AevumDecessus/Ergo-Nano/docs/images/backplate-bottom.png

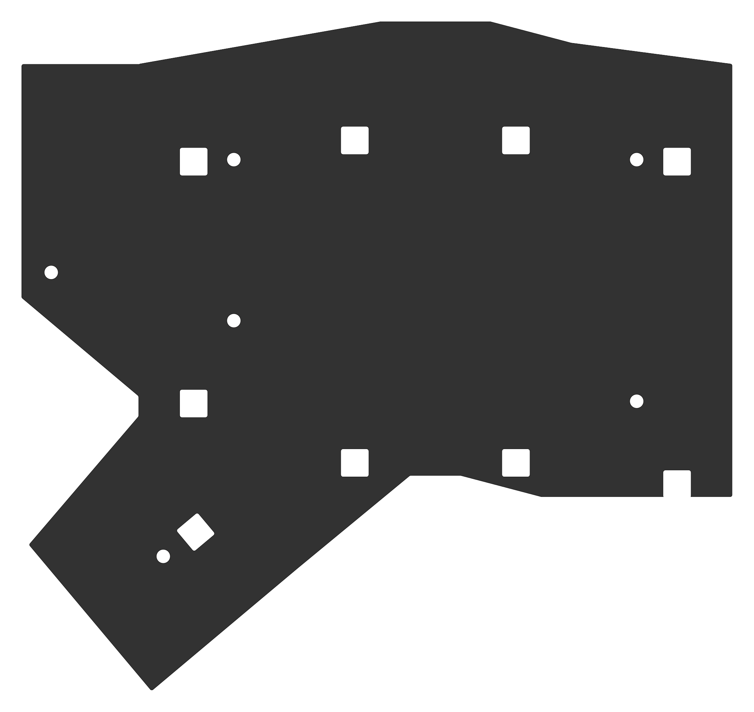
docs/images/backplate-bottom.png
