AevumDecessus/Ergo-Nano/docs/images/backplate-top.png

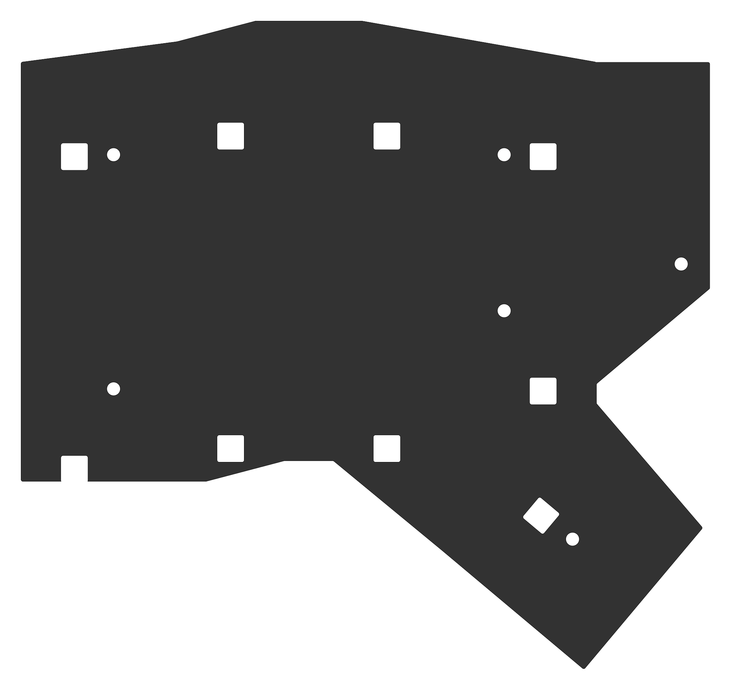
docs/images/backplate-top.png
