AevumDecessus/Ergo-Nano/docs/images/switchplate-bottom.png

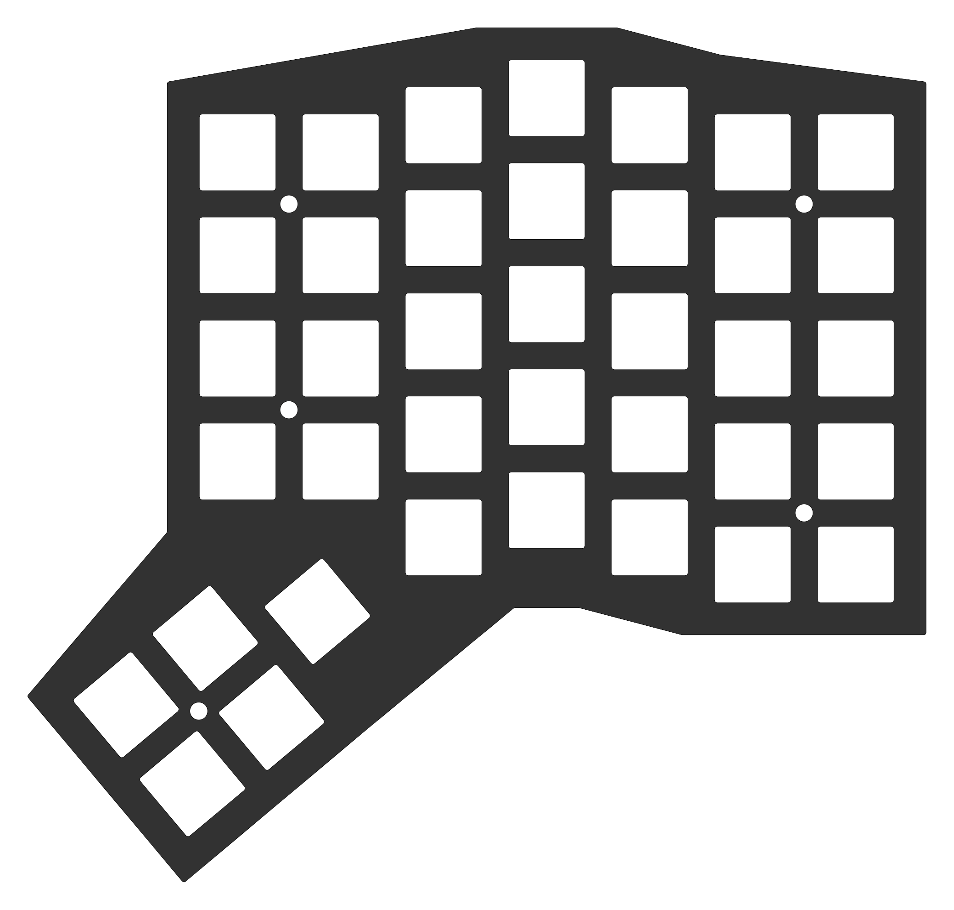
docs/images/switchplate-bottom.png
