AevumDecessus/Ergo-Nano/docs/images/switchplate-top.png

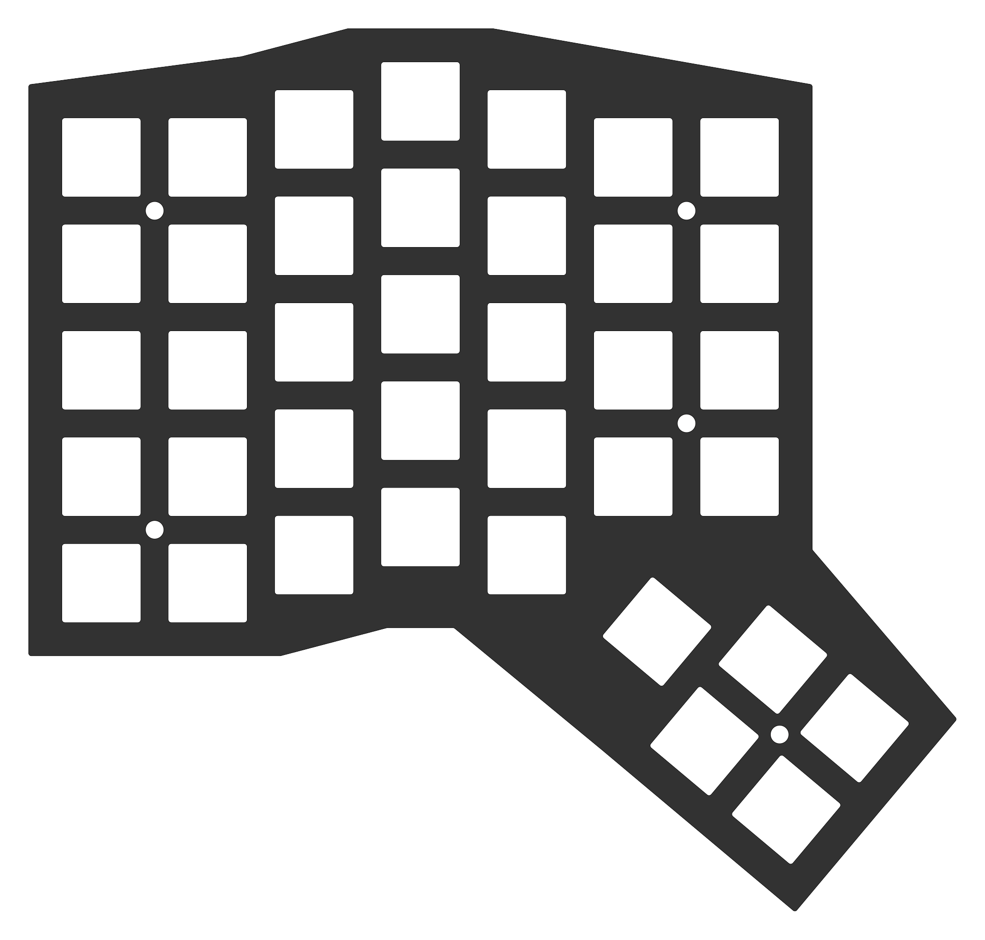
docs/images/switchplate-top.png
