AevumDecessus/Ergo-Nano/cases/bottom_plate.stl

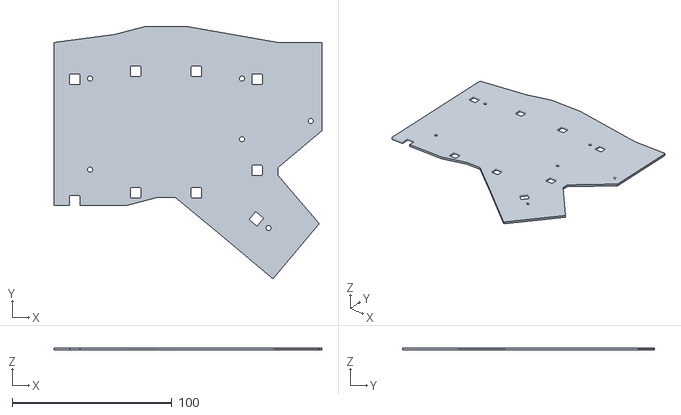
[picture p7: CAD file, 2026-11-09]
cases/bottom_plate.stl
167.6 x 157.6 x 1.50
