AevumDecessus/Ergo-Nano/outlines/preview.dxf

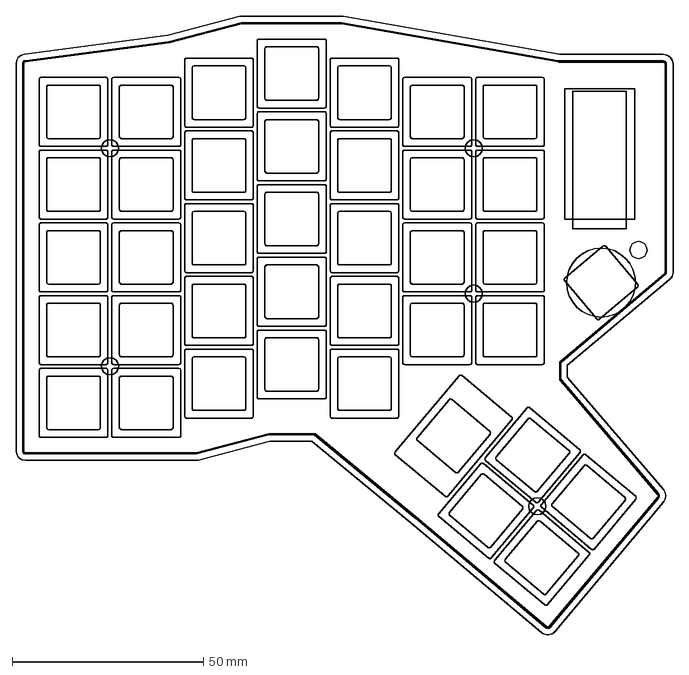
[picture p8: CAD file, 2026-11-09]
outlines/preview.dxf
171.6 x 161.7 mm
