AevumDecessus/Ergo-Nano/cases/switch_test_plate.stl

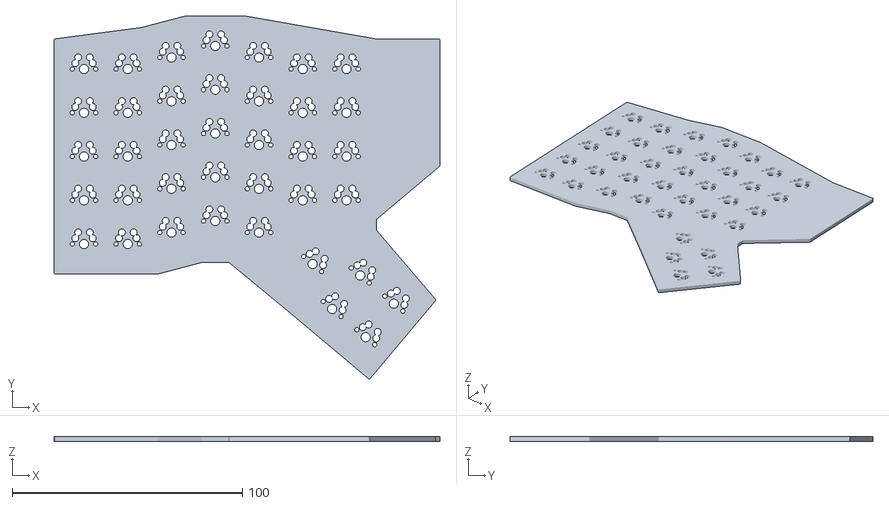
[picture p9: CAD file, 2026-11-09]
cases/switch_test_plate.stl
167.6 x 157.6 x 2.00
