AevumDecessus/Ergo-Nano/outlines/backplate.dxf

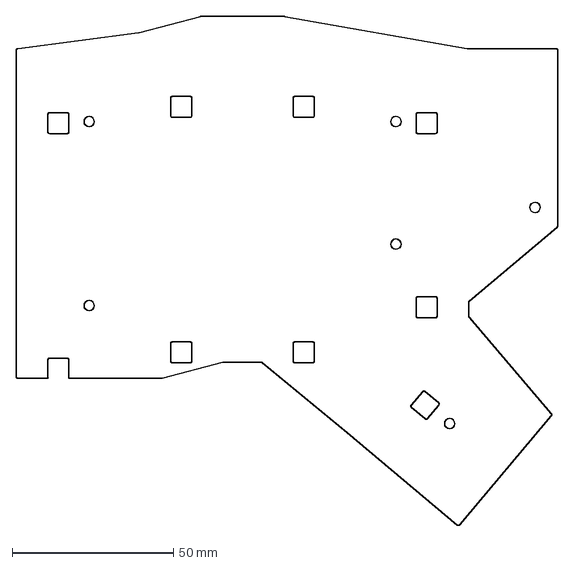
[picture p10: CAD file, 2026-11-09]
outlines/backplate.dxf
167.6 x 157.6 mm
