AevumDecessus/Ergo-Nano/cases/bottom_case_pcb.stl

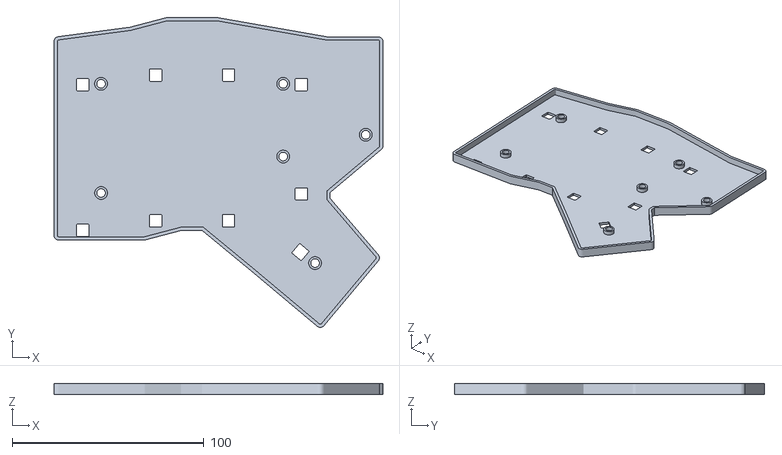
[picture p11: CAD file, 2026-11-09]
cases/bottom_case_pcb.stl
171.6 x 161.6 x 5.60
