AevumDecessus/Ergo-Nano/outlines/switchplate.dxf

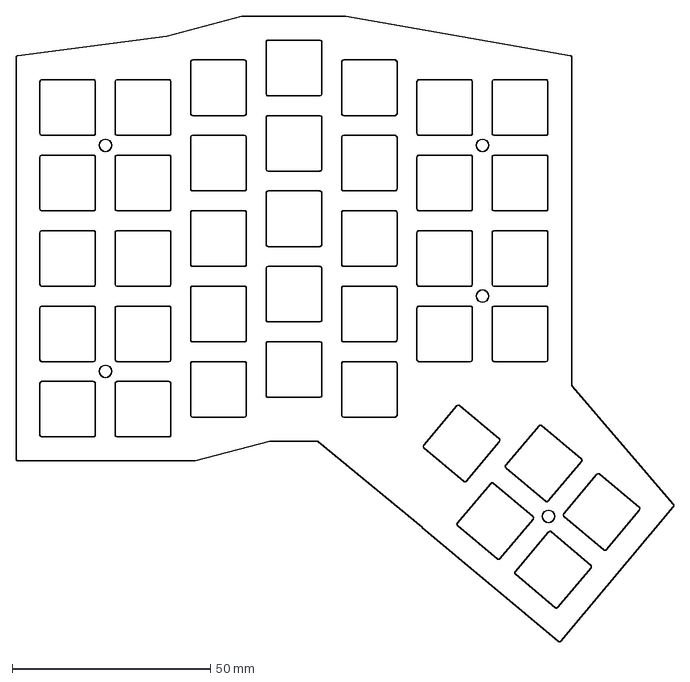
[picture p12: CAD file, 2026-11-09]
outlines/switchplate.dxf
165.8 x 157.6 mm
