AevumDecessus/Ergo-Nano/cases/bottom_case_switch.stl

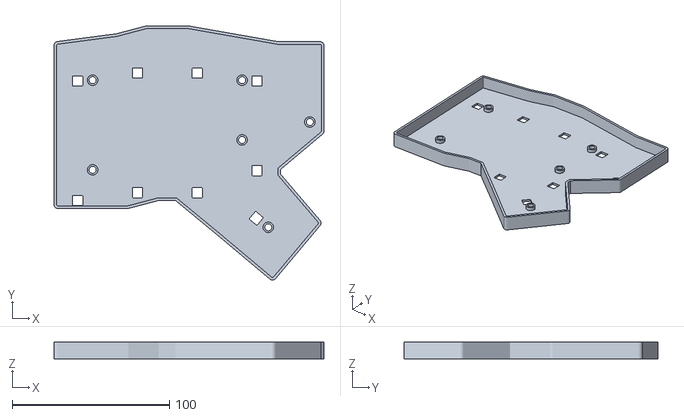
[picture p13: CAD file, 2026-11-09]
cases/bottom_case_switch.stl
171.6 x 161.6 x 10.6
