AevumDecessus/Ergo-Nano/cases/bottom_case_deep.stl

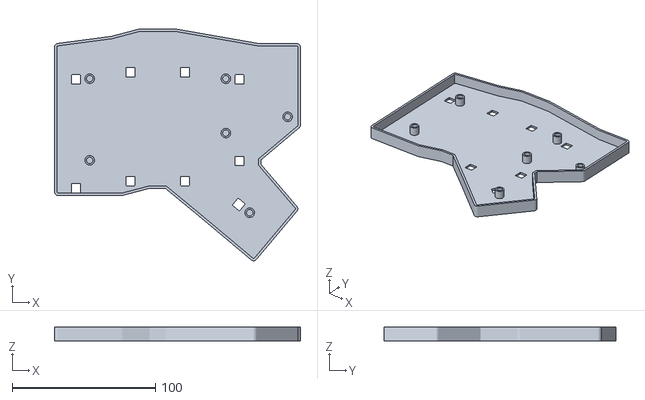
[picture p14: CAD file, 2026-11-09]
cases/bottom_case_deep.stl
171.6 x 161.6 x 9.60
