AevumDecessus/Ergo-Nano/pcbs/ergonano.kicad_pcb

## KiCad design pcbs/ergonano.kicad_pcb (2026-11-13)

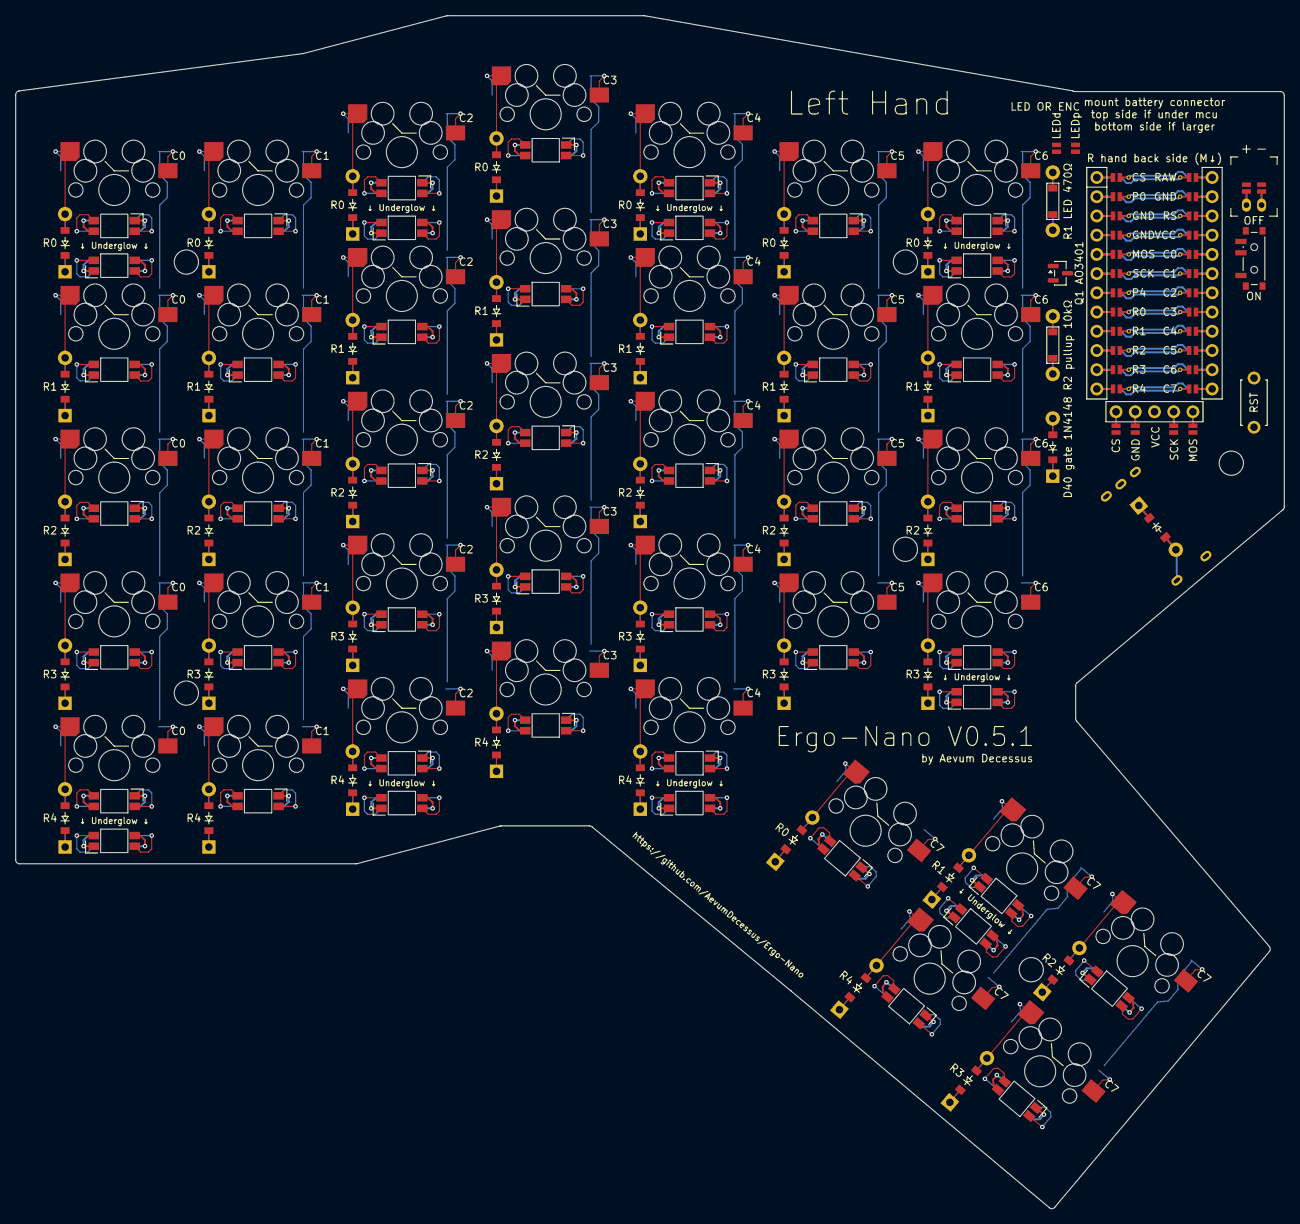
[picture p15: board ergonano.kicad_pcb from above]

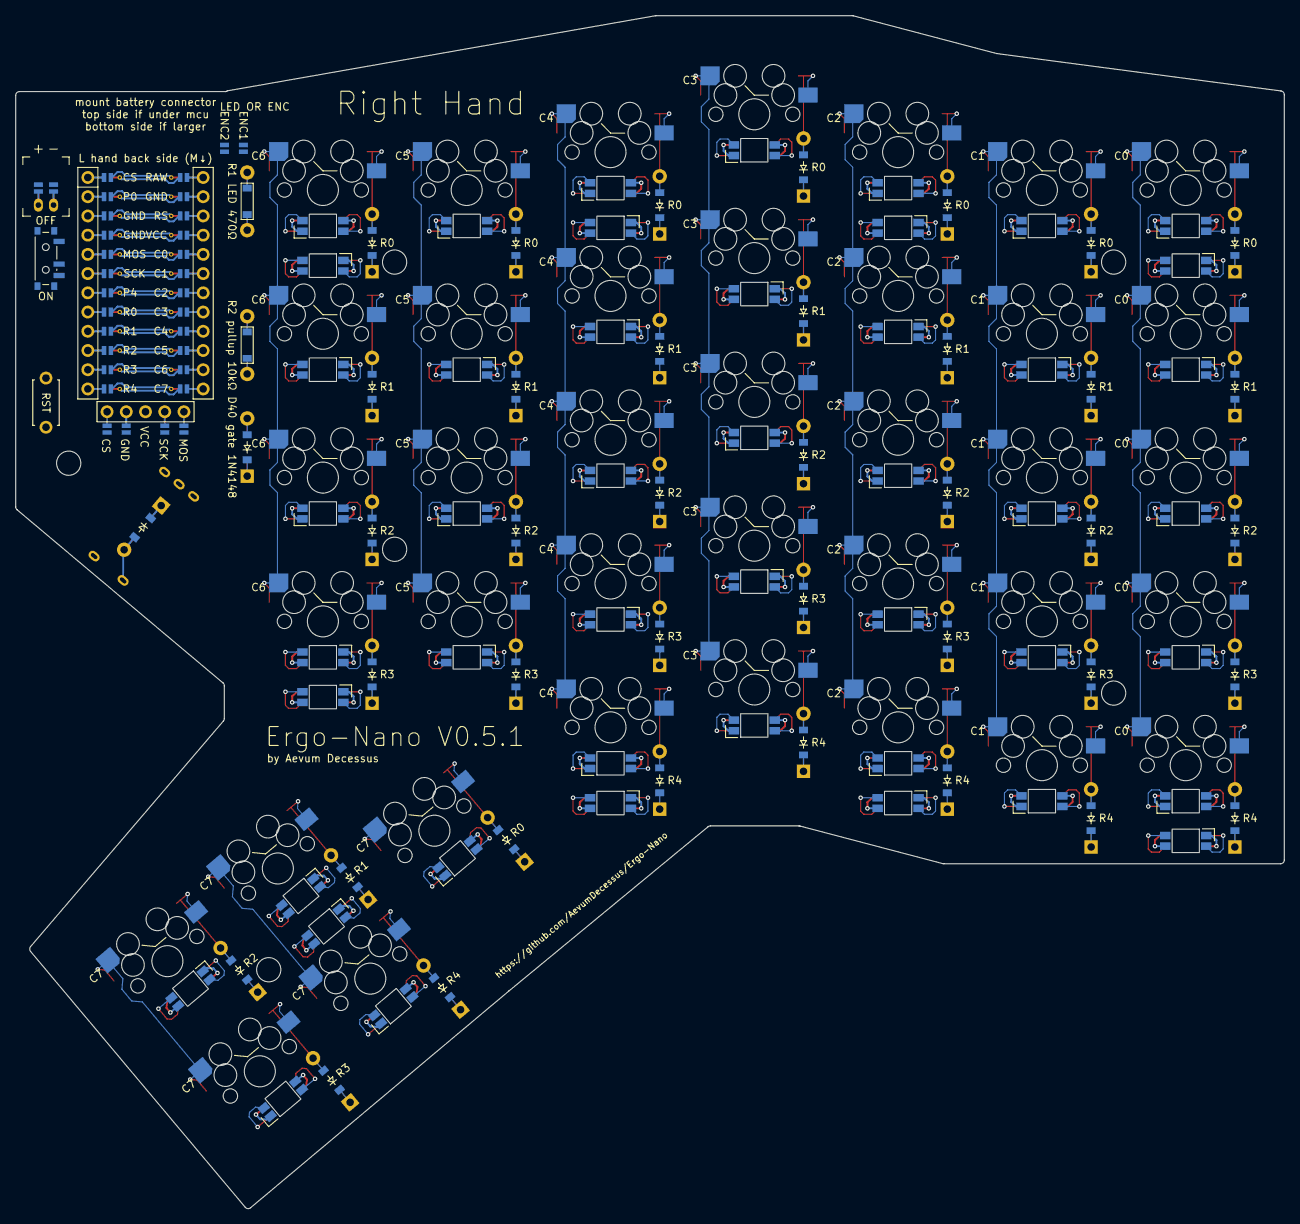
[picture p16: board ergonano.kicad_pcb from below]

Board: 2 copper layers, 167.6 x 157.6 mm, 144 parts (87 on the bottom side), 121 nets.

Parts:
D1, D2, D3, D4, D5, D6, D7, D8, D9, D10, D11, D12, D13, D14, D15, D16, D17, D18, D19, D20, D21, D22, D23, D24, D25, D26, D27, D28, D29, D30, D31, D32, D33, D34, D35, D36, D37, D38, D39, D40: diode_tht_sod123
DISP1: display_nice_view
J1, J2, J3, J4: jumper
JST1: battery_connector_jst_ph_2
LED1, LED2, LED3, LED4, LED5, LED6, LED7, LED8, LED9, LED10, LED11, LED12, LED13, LED14, LED15, LED16, LED17, LED18, LED19, LED20, LED21, LED22, LED23, LED24, LED25, LED26, LED27, LED28, LED29, LED30, LED31, LED32, LED33, LED34, LED35, LED36, LED37, LED38, LED39, LED40, LED41, LED42, LED43, LED44, LED45, LED46, LED47: led_SK6812mini-e (per-key, reversible)
MCU1: mcu_nice_nano
MH1, MH2, MH3, MH4, MH5, MH6: mounting_hole_npth
PWR1: power_switch_smd_side
Q1: SOT-23
R1, R2: resistor_tht_1206
RE1: rotary_encoder_ec11_ec12
RST1: reset_switch_tht_top
S1, S2, S3, S4, S5, S6, S7, S8, S9, S10, S11, S12, S13, S14, S15, S16, S17, S18, S19, S20, S21, S22, S23, S24, S25, S26, S27, S28, S29, S30, S31, S32, S33, S34, S35, S36, S37, S38: switch_mx

Connections:
BAT_P: JST1.1, PWR1.1, PWR1.3
C0: MCU1.105, S1.1, S1.2, S2.1, S2.2, S3.1, S3.2, S4.1, S4.2, S5.1, S5.2
C1: MCU1.106, S6.1, S6.2, S7.1, S7.2, S8.1, S8.2, S9.1, S9.2, S10.1, S10.2
C2: MCU1.107, S11.1, S11.2, S12.1, S12.2, S13.1, S13.2, S14.1, S14.2, S15.1, S15.2
C3: MCU1.108, S16.1, S16.2, S17.1, S17.2, S18.1, S18.2, S19.1, S19.2, S20.1, S20.2
C4: MCU1.109, S21.1, S21.2, S22.1, S22.2, S23.1, S23.2, S24.1, S24.2, S25.1, S25.2
C5: MCU1.110, S26.1, S26.2, S27.1, S27.2, S28.1, S28.2, S29.1, S29.2
C6: MCU1.111, RE1.S1, S30.1, S30.2, S31.1, S31.2, S32.1, S32.2, S33.1, S33.2
C7: MCU1.112, S34.1, S34.2, S35.1, S35.2, S36.1, S36.2, S37.1, S37.2, S38.1, S38.2
CS: DISP1.10, DISP1.20, MCU1.124
DISP1_1: DISP1.1, DISP1.14, DISP1.27
DISP1_2: DISP1.2, DISP1.15, DISP1.26
DISP1_4: DISP1.4, DISP1.16, DISP1.25
DISP1_5: DISP1.5, DISP1.17, DISP1.24
E1: J3.2, RE1.A
E2: J4.2, RE1.C
GND: DISP1.11, DISP1.21, JST1.2, LED1.3, LED2.3, LED3.3, LED4.3, LED5.3, LED6.3, LED7.3, LED8.3, LED9.3, LED10.3, LED11.3, LED12.3, LED13.3, LED14.3, LED15.3, LED16.3, LED17.3, LED18.3, LED19.3, LED20.3, LED21.3, LED22.3, LED23.3, LED24.3, LED25.3, LED26.3, LED27.3, LED28.3, LED29.3, LED30.3, LED31.3, LED32.3, LED33.3, LED34.3, LED35.3, LED36.3, LED37.3, LED38.3, LED39.3, LED40.3, LED41.3, LED42.3, LED43.3, LED44.3, LED45.3, LED46.3, LED47.3, MCU1.102, MCU1.121, MCU1.122, RE1.B, RST1.2
JST1_1: JST1.11, JST1.21, JST1.31
JST1_2: JST1.12, JST1.22, JST1.32
J_LED: J1.2, R1.2
J_MFET_GATE: D40.1, J2.2
LED_0: LED19.4, R1.1
LED_1: LED17.4, LED19.2
LED_2: LED15.4, LED17.2
LED_3: LED12.4, LED15.2
LED_4: LED9.4, LED12.2
LED_5: LED6.4, LED9.2
LED_6: LED3.4, LED6.2
LED_7: LED3.2, LED24.4
LED_8: LED24.2, LED26.4
LED_9: LED26.2, LED28.4
LED_10: LED28.2, LED30.4
LED_11: LED30.2, LED32.4
LED_12: LED32.2, LED34.4
LED_13: LED34.2, LED36.4
LED_14: LED18.4, LED36.2
LED_15: LED16.4, LED18.2
LED_16: LED14.4, LED16.2
LED_17: LED11.4, LED14.2
LED_18: LED8.4, LED11.2
LED_19: LED5.4, LED8.2
LED_20: LED2.4, LED5.2
LED_21: LED2.2, LED23.4
LED_22: LED23.2, LED25.4
LED_23: LED25.2, LED27.4
LED_24: LED27.2, LED29.4
LED_25: LED29.2, LED31.4
LED_26: LED31.2, LED33.4
LED_27: LED33.2, LED35.4
LED_28: LED35.2, LED37.4
LED_29: LED37.2, LED38.4
LED_30: LED22.4, LED38.2
LED_31: LED21.4, LED22.2
LED_32: LED20.4, LED21.2
LED_33: LED13.4, LED20.2
LED_34: LED10.4, LED13.2
LED_35: LED7.4, LED10.2
LED_36: LED4.4, LED7.2
LED_37: LED1.4, LED4.2
LED_MFET_GATE: D40.2, Q1.1, R2.1
LED_VCC: LED1.1, LED2.1, LED3.1, LED4.1, LED5.1, LED6.1, LED7.1, LED8.1, LED9.1, LED10.1, LED11.1, LED12.1, LED13.1, LED14.1, LED15.1, LED16.1, LED17.1, LED18.1, LED19.1, LED20.1, LED21.1, LED22.1, LED23.1, LED24.1, LED25.1, LED26.1, LED27.1, LED28.1, LED29.1, LED30.1, LED31.1, LED32.1, LED33.1, LED34.1, LED35.1, LED36.1, LED37.1, LED38.1, LED39.1, LED40.1, LED41.1, LED42.1, LED43.1, LED44.1, LED45.1, LED46.1, LED47.1, Q1.3
MOS: DISP1.13, DISP1.23, MCU1.120
P0: J1.1, J3.1, MCU1.123
P4: J2.1, J4.1, MCU1.118
R0: D5.1, D10.1, D15.1, D20.1, D25.1, D29.1, D33.1, D34.1, MCU1.117
R1: D4.1, D9.1, D14.1, D19.1, D24.1, D28.1, D32.1, D36.1, MCU1.116
R2: D3.1, D8.1, D13.1, D18.1, D23.1, D27.1, D31.1, D38.1, MCU1.115
R3: D2.1, D7.1, D12.1, D17.1, D22.1, D26.1, D30.1, D37.1, MCU1.114
R4: D1.1, D6.1, D11.1, D16.1, D21.1, D35.1, D39.1, MCU1.113
RAW: MCU1.101, PWR1.2, Q1.2, R2.2
RS: MCU1.103, RST1.1
SCK: DISP1.12, DISP1.22, MCU1.119
ULED_1: LED1.2, LED39.4
ULED_2: LED39.2, LED40.4
ULED_3: LED40.2, LED41.4
ULED_4: LED41.2, LED42.4
ULED_5: LED42.2, LED43.4
ULED_6: LED43.2, LED44.4
ULED_7: LED44.2, LED45.4
ULED_8: LED45.2, LED46.4
ULED_9: LED46.2, LED47.4
VCC: DISP1.3, MCU1.104
encoder_encoder: D39.2, RE1.S2
index_bottom: D22.2, S22.1, S22.2
index_home: D23.2, S23.1, S23.2
index_mod: D21.2, S21.1, S21.2
index_num: D25.2, S25.1, S25.2
index_top: D24.2, S24.1, S24.2
inner_bottom: D26.2, S26.1, S26.2
inner_home: D27.2, S27.1, S27.2
inner_num: D29.2, S29.1, S29.2
inner_top: D28.2, S28.1, S28.2
innermod_bottom: D30.2, S30.1, S30.2
innermod_home: D31.2, S31.1, S31.2
innermod_num: D33.2, S33.1, S33.2
innermod_top: D32.2, S32.1, S32.2
middle_bottom: D17.2, S17.1, S17.2
middle_home: D18.2, S18.1, S18.2
middle_mod: D16.2, S16.1, S16.2
middle_num: D20.2, S20.1, S20.2
middle_top: D19.2, S19.1, S19.2
outer_bottom: D2.2, S2.1, S2.2
outer_home: D3.2, S3.1, S3.2
outer_mod: D1.2, S1.1, S1.2
outer_num: D5.2, S5.1, S5.2
outer_top: D4.2, S4.1, S4.2
pinky_bottom: D7.2, S7.1, S7.2
pinky_home: D8.2, S8.1, S8.2
pinky_mod: D6.2, S6.1, S6.2
pinky_num: D10.2, S10.1, S10.2
pinky_top: D9.2, S9.1, S9.2
ring_bottom: D12.2, S12.1, S12.2
ring_home: D13.2, S13.1, S13.2
ring_mod: D11.2, S11.1, S11.2
ring_num: D15.2, S15.1, S15.2
ring_top: D14.2, S14.1, S14.2
t_col0_near: D34.2, S34.1, S34.2
t_col1_far: D36.2, S36.1, S36.2
t_col1_near: D35.2, S35.1, S35.2
t_col2_far: D38.2, S38.1, S38.2
t_col2_near: D37.2, S37.1, S37.2
