AevumDecessus/Ergo-Nano/ergogen/config.yaml

meta:
  engine: 4.2.0
  name: &kb_name Ergo-Nano
  version: &version 0.5.1
  author: &kb_author Aevum Decessus
  url: &kb_url https://github.com/AevumDecessus/Ergo-Nano
units:
  # Web View Resizing
  $default_width: U
  $default_height: U
  kx: U
  ky: U
  ks: 19 # horizontal space between columns (default: 19)
  kp: 19 # vertical padding between keys (deafult: 19)
  half_kx: 0.5kx
  half_ky: 0.5ky
  # Cutouts
  kcow: 14 #key cutout hole width
  kcoh: 14 #key cutout hole height
  # Keycaps
  keycw: 18 # keycap width (cherry)
  keych: 18 # keycap height (cherry)
  # Padding Variables
  padding: 7
  mcu_padding: 8 # Padding to the right of the MCU for connctors/etc
  px: kx + padding
  py: ky + padding
  half_px: 0.5px
  half_py: 0.5py
  dpx: 2px
  dpy: 2py
  # MCU
  mcu_width: 18.3
  mcu_height: 34.1
  # display
  display_width: 14
  display_height: 36
  display_vert_shift: 2.5
  # Relative column staggers
  st_outer: 0
  st_pinky: 0
  st_ring: 5
  st_middle: 5
  st_index: -5
  st_inner: -5
  st_innermod: 0
  # pre-evaluate target traces between column staggers
  diode_x: 6.5
  diode_y: -6 #Negative to place the diode, positive for routing position
  diode_length: 4
  # led settings
  led_pos_x: 0
  led_pos_y: 4.75
  led_rotation: 180
  underglow_vert_shift: -10
  # kicad shifts
  kicad_shift_x: 50
  kicad_shift_y: -125
  # Tolerances
  board_tolerance: 0.3 #Leave this much space around the board in the case
  fillet_radius: 0.5
  # M3 specific sizes
  m3_hole: 3.2
  m3_heatset_hole: 4.5
  m3_heatset_height: 4
  m3_socket_head_size: 5.5
  # Board sizes inheriting chosen size
  screw_hole: m3_hole
  screw_head: m3_socket_head_size
  heatset_hole: m3_heatset_hole
  heatset_height: m3_heatset_height
  standoff_height_deep: 8
  standoff_size: screw_hole + (padding / 2)
  # Board Settings
  via_size: 0.6 # JLCPCB min 0.56 | KiCad default 0.8
  via_drill: 0.3 # JLCPCB min 0.3 | KiCad default 0.4
  pwr_trace_width: 0.25
  gnd_trace_width: 0.25
  signal_trace_width: 0.15
  # plate sizes
  pcb_thickness: 1.6
  plate_thickness: 1.5
  top_plate_surface: 5
  gap_pcb_top_plate: top_plate_surface - plate_thickness
  wall_thickness: 2
  wall_height_switch_plate: heatset_height + pcb_thickness + plate_thickness + gap_pcb_top_plate
  wall_height_pcb: heatset_height + pcb_thickness
  wall_height_deep: standoff_height_deep + pcb_thickness
  # Extrudes the walls to be level with the top of the PCB
points:
  key:
    kb_author: *kb_author
    kb_name: *kb_name
    kb_url: *kb_url
    version: *version
  zones:
    matrix:
      key:
        padding: kp
        tags: [keyswitch, matrix_key, keyswitch_diode, keycap_1u]
      anchor:
        shift: [kicad_shift_x, kicad_shift_y]
      columns:
        outer:
          key:
            next_col_stagger: st_pinky
            column_net: C0
            stagger: st_outer
          rows:
            num.key:
              led_prev: LED_6
              led_next: LED_7
            top.key:
              led_prev: LED_7
              led_next: LED_8
            home.key:
              led_prev: LED_20
              led_next: LED_21
            bottom.key:
              led_prev: LED_21
              led_next: LED_22
            mod.key:
              led_prev: LED_37
              led_next: ULED_1
        pinky:
          key:
            column_net: C1
            stagger: st_pinky
            next_col_stagger: st_ring
            prev_col_stagger: st_pinky
          rows:
            num.key:
              led_prev: LED_5
              led_next: LED_6
            top.key:
              led_prev: LED_8
              led_next: LED_9
            home.key:
              led_prev: LED_19
              led_next: LED_20
            bottom.key:
              led_prev: LED_22
              led_next: LED_23
            mod.key:
              led_prev: LED_36
              led_next: LED_37
        ring:
          key:
            column_net: C2
            stagger: st_ring
            next_col_stagger: st_middle
            prev_col_stagger: st_pinky
          rows:
            num.key:
              led_prev: LED_4
              led_next: LED_5
            top.key:
              led_prev: LED_9
              led_next: LED_10
            home.key:
              led_prev: LED_18
              led_next: LED_19
            bottom.key:
              led_prev: LED_23
              led_next: LED_24
            mod.key:
              led_prev: LED_35
              led_next: LED_36
        middle:
          key:
            column_net: C3
            stagger: st_middle
            next_col_stagger: st_index
            prev_col_stagger: st_ring
          rows:
            num.key:
              led_prev: LED_3
              led_next: LED_4
            top.key:
              led_prev: LED_10
              led_next: LED_11
            home.key:
              led_prev: LED_17
              led_next: LED_18
            bottom.key:
              led_prev: LED_24
              led_next: LED_25
            mod.key:
              led_prev: LED_34
              led_next: LED_35
        index:
          key:
            column_net: C4
            stagger: st_index
            next_col_stagger: st_inner
            prev_col_stagger: st_middle
          rows:
            num.key:
              led_prev: LED_2
              led_next: LED_3
            top.key:
              led_prev: LED_11
              led_next: LED_12
            home.key:
              led_prev: LED_16
              led_next: LED_17
            bottom.key:
              led_prev: LED_25
              led_next: LED_26
            mod.key:
              led_prev: LED_33
              led_next: LED_34
        inner:
          key:
            column_net: C5
            stagger: st_inner
            next_col_stagger: st_innermod
            prev_col_stagger: st_index
          rows:
            num.key:
              led_prev: LED_1
              led_next: LED_2
            top.key:
              led_prev: LED_12
              led_next: LED_13
            home.key:
              led_prev: LED_15
              led_next: LED_16
            bottom.key:
              led_prev: LED_26
              led_next: LED_27
          rows.mod.skip: true
        innermod:
          key: 
            column_net: C6
            stagger: st_innermod
            prev_key_stagger: st_inner
          rows:
            num.key:
              led_prev: LED_0
              led_next: LED_1
            top.key:
              led_prev: LED_13
              led_next: LED_14
            home.key:
              led_prev: LED_14
              led_next: LED_15
            bottom.key:
              led_prev: LED_27
              led_next: LED_28
          rows.mod.skip: true
      rows:
        mod:
          key.led_dir: RL
          row_net: R4
        bottom:
          key.led_dir: LR
          row_net: R3
        home:
          key.led_dir: RL
          row_net: R2
        top:
          key.led_dir: LR
          row_net: R1
        num:
          key.led_dir: RL
          row_net: R0
    thumbs:
      key:
        padding: 1kp
        spread: 1ky
        tags: [keyswitch, thumb_cluster, keyswitch_diode, keycap_1u]
      anchor:
        ref: matrix_index_mod
        shift: [0.9kx,-1.1ky]
        rotate: -40
      columns:
        t_col0:
          key:
            tags: [keyswitch, thumb_cluster, keyswitch_diode, keycap_1_5u_vert]
            column_net: C7
            height: 1.5ky
            shift: [0, half_ky]
          rows:
            near.key:
              led_prev: LED_32
              led_next: LED_33
          rows.far.skip: true
          rows.near.row_net: R0
        t_col1:
          key:
            column_net: C7
          rows:
            near.key:
              led_prev: LED_31
              led_next: LED_32
            far.key:
              led_prev: LED_28
              led_next: LED_29
          rows.near.row_net: R4
          rows.far.row_net: R1
        t_col2:
          key:
            column_net: C7
          rows:
            near.key:
              led_prev: LED_30
              led_next: LED_31
            far.key:
              led_prev: LED_29
              led_next: LED_30
          rows.near.row_net: R3
          rows.far.row_net: R2
      rows:
        near:
          key.led_dir: RL
        far:
          key.led_dir: LR
    encoder_mcu:
      columns:
        encoder:
          key:
            column_net: C6
            tags: [encoder]
          rows.encoder.row_net: R4
      anchor:
        ref: matrix_innermod_bottom
        shift: [1.25kx, 0.65ky]
        rotate: 40
    underglow_led_1:
      key:
        tags: [helper, underglow]
        din: ULED_1
        dout: ULED_2
      anchor:
        ref: matrix_outer_mod
        shift: [0, underglow_vert_shift]
    underglow_led_2:
      key:
        tags: [helper, underglow]
        din: ULED_2
        dout: ULED_3
      anchor:
        ref: matrix_ring_mod
        shift: [0, underglow_vert_shift]
    underglow_led_3:
      key:
        tags: [helper, underglow]
        din: ULED_3
        dout: ULED_4
      anchor:
        ref: matrix_index_mod
        shift: [0, underglow_vert_shift]
    underglow_led_4:
      key:
        tags: [helper, underglow]
        din: ULED_4
        dout: ULED_5
      anchor:
        ref: thumbs_t_col1_far
        shift: [0, underglow_vert_shift]
    underglow_led_5:
      key:
        tags: [helper, underglow]
        din: ULED_5
        dout: ULED_6
      anchor:
        ref: matrix_innermod_bottom
        shift: [0, underglow_vert_shift]
    underglow_led_6:
      key:
        tags: [helper, underglow]
        din: ULED_6
        dout: ULED_7
      anchor:
        ref: matrix_innermod_num
        shift: [0, underglow_vert_shift]
    underglow_led_7:
      key:
        tags: [helper, underglow]
        din: ULED_7
        dout: ULED_8
      anchor:
        ref: matrix_index_num
        shift: [0, underglow_vert_shift]
    underglow_led_8:
      key:
        tags: [helper, underglow]
        din: ULED_8
        dout: ULED_9
      anchor:
        ref: matrix_ring_num
        shift: [0, underglow_vert_shift]
    underglow_led_9:
      key:
        tags: [helper, underglow]
        din: ULED_9
        dout: ULED_10
      anchor:
        ref: matrix_outer_num
        shift: [0, underglow_vert_shift]
    screw_top_left:
      key.tags: [helper, screws]
      anchor:
        ref: matrix_outer_num
        shift: [half_kx, -half_ky]
    screw_top_right:
      key.tags: [helper, screws]
      anchor:
        ref: matrix_inner_num
        shift: [half_kx, -half_ky]
    screw_bottom_left:
      key.tags: [helper, screws]
      anchor:
        ref: matrix_outer_mod
        shift: [half_kx, half_ky]
    screw_thumbs_right_center:
      key.tags: [helper, screws]
      anchor:
        ref: thumbs_t_col2_near
        shift: [-half_kx, half_ky]
    screw_bottom_right:
      key.tags: [helper, screws]
      anchor:
        ref: matrix_inner_bottom
        shift: [half_kx, half_ky]
    mcu_top_left:
      key.tags: [helper, mcu]
      anchor:
        - ref: matrix_innermod_num
          shift: [0.75kx,6]
    mcu_top_right:
      key.tags: [helper, mcu]
      anchor:
        - ref: mcu_top_left
          shift: [mcu_width,0]
    mcu_bottom_right:
      key.tags: [helper, mcu]
      anchor:
        - ref: mcu_top_right
          shift: [0,-mcu_height]
    mcu_bottom_left:
      key.tags: [helper, mcu]
      anchor:
        - ref: mcu_top_left
          shift: [0,-mcu_height]
    display_bottom_left:
      key.tags: [helper, display]
      anchor:
        - ref: mcu_bottom_left
          shift: [mcu_width / 2 - display_width / 2, -display_vert_shift]
    display_bottom_right:
      key.tags: [helper, display]
      anchor:
        - ref: display_bottom_left
          shift: [display_width, 0]
    display_top_left:
      key.tags: [helper, display]
      anchor:
        - ref: display_bottom_left
          shift: [0, display_height]
    display_top_right:
      key.tags: [helper, display]
      anchor:
        - ref:  display_bottom_left
          shift: [display_width, display_height]
    screw_mcu_bottom_right:
      key.tags: [helper, screws_expand]
      anchor:
        - ref: mcu_bottom_right
          shift: [1, -8]
outlines:
  _matrix_outline: #Outline around all keys only with half a key of padding around
    - what: polygon
      operation: stack
      points:
        - ref: matrix_outer_num
          shift: [-half_px,half_py]
        - ref: matrix_ring_num
          shift: [-half_px,half_py]
        - ref: matrix_middle_num
          shift: [-half_px,half_py]
        - ref: matrix_middle_num
          shift: [half_px,half_py]
        - ref: matrix_innermod_num
          shift: [half_px,half_py]
        - ref: matrix_innermod_bottom
          shift: [half_px,-half_py]
        - ref: thumbs_t_col2_far
          shift: [half_px,half_py]
        - ref: thumbs_t_col2_near
          shift: [half_px,-half_py]
        - ref: thumbs_t_col1_near
          shift: [-half_px,-half_py]
        - ref: matrix_index_mod
          shift: [-half_px,-half_py]
        - ref: matrix_ring_mod
          shift: [half_px, -half_py]
        - ref: matrix_pinky_mod
          shift: [half_px, -half_py]
        - ref: matrix_outer_mod
          shift: [-half_px,-half_py]
      fillet: fillet_radius
  _mcu_outline: # Outline around the MCU, angled at the botom to merge more cleanly with the matrix
    - what: polygon
      operation: stack
      points:
        - ref: mcu_top_left
          shift: [-padding, padding]
        - ref: mcu_top_right # bottom right space for the MCU
          shift: [mcu_padding, padding]
        - ref: mcu_bottom_right
          shift: [mcu_padding, -2padding]
        - ref: mcu_bottom_left
          shift: [-padding, -6padding]
      fillet: fillet_radius
  _mcu_tight: # Exact size of the MCU, used to show it's position on the combo dxf
    - what: polygon
      operation: stack
      points:
        - mcu_top_left
        - mcu_top_right
        - mcu_bottom_right
        - mcu_bottom_left
  _mcu_tolerance: # The MCU board with a tolerance gap - Used if we want to extend the switch plate to cover the whole PCB
    - what: outline
      name: _mcu_tight
      expand: board_tolerance
      fillet: fillet_radius
  _display_tight:
    - what: polygon
      operation: stack
      points:
        - display_bottom_left
        - display_bottom_right
        - display_top_right
        - display_top_left
  ## PCB ##
  _pcb_outline: # Merged matrix and MCU outline to form the PCB shape
    - what: outline
      name: _mcu_outline
    - what: outline
      name: _matrix_outline
      operation: add
      fillet: fillet_radius
  ## Standoffs and screws ##
  _standoffs: # The circles for each screw showing standoff size
    - what: circle
      radius: standoff_size / 2
      where: /^screws/
  _standoff_holes: # The heaset holes themselves for the bottom case
    - what: circle
      radius: heatset_hole / 2
      where: /^screws/
  _screw_holes: # screw_holes for the bottom plate if not using a case
    - what: circle
      radius: screw_hole / 2
      where: /^screws/
  _screw_heads:
    - what: circle
      radius: screw_head / 2
      where: /^screws/
  ## Underglow LEDs ##
  _underglow_holes:
    - what: rectangle
      size: 6.5
      where: [underglow]
      fillet: fillet_radius
  ## Switch Plate ##
  _switch_cutouts: # Switch cutouts to form the switch plate
    - what: rectangle
      fillet: fillet_radius
      where: [keyswitch]
      size: [kcow, kcoh]
    - what: rectangle
      fillet: fillet_radius
      where: [encoder]
      size: [kcow, kcoh]
  _switchplate_base:
    - what: outline
      name: _matrix_outline
    - what: outline
      name: _switch_cutouts
      operation: subtract
  switchplate:
    - what: outline
      name: _switchplate_base
    - what: outline
      name: _screw_holes
      operation: subtract
  ## Switch Specific
  _mx_reversible_circles:
    - what: circle             # centre post
      where: [keyswitch]
      radius: 2
    - what: circle             # side‑peg A (left)
      where: [keyswitch]
      radius: 0.95
      adjust:
        shift: [ 5.08, 0 ]
    - what: circle            # side‑peg B (right)
      where: [keyswitch]
      radius: 0.95
      adjust:
        shift: [  -5.08, 0 ]
    - what: circle
      where: [keyswitch]
      radius: 1.5
      adjust:
        shift: [-2.54, 5.08]
    - what: circle
      where: [keyswitch]
      radius: 1.5
      adjust:
        shift: [2.54, 5.08]
    - what: circle
      where: [keyswitch]
      radius: 1.5
      adjust:
        shift: [-3.81, 2.54]
    - what: circle
      where: [keyswitch]
      radius: 1.5
      adjust:
        shift: [3.81, 2.54]
  _switch_test_plate:
    - what: outline
      name: _pcb_outline
      operation: add
    - what: outline
      name: _mx_reversible_circles
      operation: subtract 
  ## Back Plate
  _backplate_base:
    - what: outline
      name: _pcb_outline
    - what: outline
      name: _underglow_holes
      operation: subtract
  backplate:
    - what: outline
      name: _backplate_base
    - what: outline
      name: _screw_holes
      operation: subtract
  ## Keycaps
  _keycap_outlines:
    - what: rectangle
      fillet: fillet_radius
      where: [keycap_1u]
      size: [keycw, keych]
    - what: rectangle
      fillet: fillet_radius
      where: [keycap_1_5u_vert]
      size: [keycw, 1.5keych]
    - what: circle
      where: [encoder]
      radius: keycw / 2
  ## Case Wall ##
  _outer_wall: # 0.5 padding bigger than board - forms the outer wall of the case
    - what: outline
      name: _pcb_outline
      expand: wall_thickness
  _inner_wall: # Tolerance gap around the whole PCB, forms the inner wall of the case
    - what: outline
      name: _pcb_outline
      expand: board_tolerance
  _case_wall: # A wall from the inner and outer walls defined above
    - name: _outer_wall
    - operation: subtract
      name: _inner_wall
  preview: # Preview output of most of the major elements
    - name: _outer_wall
      operation: stack
    - name: _inner_wall
      operation: stack
    - name: _pcb_outline
      operation: stack
    - name: _mcu_tight
      operation: stack
    - name: _display_tight
      operation: stack
    - name: _switch_cutouts
      operation: stack
    - name: _keycap_outlines
      operation: stack
    - name: _standoff_holes
      operation: stack
pcbs:
  backplate:
    template: kicad8
    outlines:
      main:
        outline: _backplate_base
    footprints:
      ## Screw Holes ##
      board_mounting_holes:
        what: ceoloide/mounting_hole_npth
        where: /^screws/
        params:
          hole_size: screw_hole
          hole_drill: screw_hole
          designator: 'MH'
  switchplate:
    template: kicad8
    outlines:
      main:
        outline: _switchplate_base
    footprints:
      ## Screw Holes ##
      board_mounting_holes:
        what: ceoloide/mounting_hole_npth
        where: /^screws$/ #Don't try to cut the screws_expand holes
        params:
          hole_size: screw_hole
          hole_drill: screw_hole
          designator: 'MH'
  ergonano:
    template: kicad8
    outlines:
      main:
        outline: _pcb_outline
    footprints:
      mx:
        what: ceoloide/switch_mx
        where: [keyswitch]
        adjust:
          rotate: 180
        params:
          hotswap: true
          hotswap_pads_same_side: true
          reversible: true
          include_silkscreen: true
          include_corner_marks: true
          include_keycap: false
          include_plated_holes: false
          include_centerhole_net: false
          include_stabilizer_nets: false
          outer_pad_width_front: 2
          outer_pad_width_back: 2
          outer_pad_height: 2
          trace_width: signal_trace_width
          via_drill: via_drill
          via_size: via_size
          keycap_width: keycw
          keycap_height: keych
          locked_traces_vias: false
          LEFTSTAB: "{{colrow}}"
          RIGHTSTAB: "{{column_net}}"
          from: "{{column_net}}"
          to: "{{colrow}}"
      per_key_leds_RL:
        what: ceoloide/led_sk6812mini-e
        where: meta.key.led_dir ~ RL
        params:
          P1: LED_VCC
          P2: "{{key.led_next}}" #DOUT
          P3: GND
          P4: "{{key.led_prev}}" #DIN
          reversible: true
          reverse_mount: true
          include_traces_vias: true
          include_keepout: false
          include_courtyard: false
          signal_trace_width: signal_trace_width
          gnd_trace_width: gnd_trace_width
          vcc_trace_width: pwr_trace_width
          via_size: via_size
          via_drill: via_drill
        adjust:
          shift: [led_pos_x, led_pos_y]
          rotate: led_rotation
      per_key_leds_LR:
        what: ceoloide/led_sk6812mini-e
        where: meta.key.led_dir ~ LR
        params:
          P1: LED_VCC
          P2: "{{key.led_next}}" #DOUT
          P3: GND
          P4: "{{key.led_prev}}" #DIN
          reversible: true
          reverse_mount: true
          include_traces_vias: true
          include_keepout: false
          include_courtyard: false
          signal_trace_width: signal_trace_width
          gnd_trace_width: gnd_trace_width
          vcc_trace_width: pwr_trace_width
          via_size: via_size
          via_drill: via_drill
        adjust:
          shift: [led_pos_x, led_pos_y]
          rotate: led_rotation + 180
      underglow_leds:
        what: ceoloide/led_sk6812mini-e
        where: [underglow]
        params:
          P1: LED_VCC
          P2: "{{zone.key.dout}}"
          P3: GND
          P4: "{{zone.key.din}}"
          reversible: true
          reverse_mount: true
          include_traces_vias: true
          include_keepout: false
          include_courtyard: false
          signal_trace_width: signal_trace_width
          gnd_trace_width: gnd_trace_width
          vcc_trace_width: pwr_trace_width
          via_size: via_size
          via_drill: via_drill
      underglow_text:
        what: ceoloide/utility_text
        where: [underglow]
        adjust:
          shift: [0, 2.65]
        params:
          text: ↓ Underglow ↓
          height: 0.8
          width: 0.8
      diode:
        what: ceoloide/diode_tht_sod123
        where: [keyswitch_diode]
        params:
          reversible: true
          include_tht: true
          include_traces_vias: true
          trace_width: signal_trace_width
          via_size: via_size
          via_drill: via_drill
          from: "{{colrow}}"
          to: "{{row_net}}"
        adjust:
          shift: [diode_x, -diode_y]
          rotate: 270
      nice-nano:
        what: ceoloide/mcu_nice_nano
        params:
          reverse_mount: true
          reversible: true
          include_traces: true
          invert_jumpers_position: false
          show_silk_labels: true
          show_via_labels: true
          use_rectangular_jumpers: true
          via_size: via_size
          via_drill: via_drill
          P0: P0
          P1: CS
          P2: MOS
          P3: SCK
          P4: P4
          P5: R0
          P6: R1
          P7: R2
          P8: R3
          P9: R4
          P21: C0
          P20: C1
          P19: C2
          P18: C3
          P15: C4
          P14: C5
          P16: C6
          P10: C7
          RST: RS
        where:
          ref: mcu_top_left
          shift: [(mcu_width / 2), -(mcu_height / 2)]
      nice-view:
        what: aevumdecessus/display_nice_view
        where:
          ref: display_bottom_left
          shift: [display_width / 2, display_height / 2]
        params:
          reversible: true
          gnd_trace_width: gnd_trace_width
          signal_trace_width: signal_trace_width
          include_silkscreen: true
          invert_jumpers_position: true # Jumpers below MCU and headers
          include_courtyard: false
          MOSI: MOS
      led_array_resistor:
        what: aevumdecessus/resistor_tht_1206
        where:
          ref: matrix_innermod_num
          shift: [10,-1.5]
          rotate: 90
        params:
          include_tht: true
          reversible: true
          include_traces_vias: true
          trace_width: signal_trace_width
          from: J_LED
          to: LED_0
      led_array_resistor_text:
        what: ceoloide/utility_text
        where:
          ref: matrix_innermod_num
          shift: [12, -1.5]
          rotate: 90
        params:
          text: R1 LED 470Ω
          reversible: true
      led_mosfet:
        what: aevumdecessus/sot-23
        where:
          ref: matrix_innermod_top
          shift: [11, 8]
        params:
          side: F
          P1: LED_MFET_GATE
          P2: RAW # Source - battery power
          P3: LED_VCC # Drain - LED power net
      led_mosfet_text:
        what: ceoloide/utility_text
        where:
          ref: matrix_innermod_top
          shift: [13.5, 8]
          rotate: 90
        params:
          side: F
          text: Q1 AO3401
      led_mosfet_pullup_resistor:
        what: aevumdecessus/resistor_tht_1206
        where:
          ref: matrix_innermod_top
          shift: [10,-1.5]
          rotate: 90
        params:
          include_tht: true
          reversible: true
          include_traces_vias: true
          trace_width: signal_trace_width
          from: RAW
          to: LED_MFET_GATE
      led_mosfet_pullup_resistor_text:
        what: ceoloide/utility_text
        where:
          ref: matrix_innermod_top
          shift: [12, -1.5]
          rotate: 90
        params:
          text: R2 pullup 10kΩ
          reversible: true
      # Jumpers and labels - choose between LEDs or Encoder
      led_data_jumper:
        what: aevumdecessus/jumper
        where:
          ref: matrix_innermod_num
          shift: [10.5,5.5]
          rotate: 270
        params:
          side: F
          from: P0
          to: J_LED
      led_mostfet_jumper:
        what: aevumdecessus/jumper
        where:
          ref: matrix_innermod_num
          shift: [13,5.5]
          rotate: 270
        params:
          side: F
          from: P4
          to: J_MFET_GATE
      led_data_jumper_label:
        what: ceoloide/utility_text
        where:
          ref: matrix_innermod_num
          shift: [10.5,8.5]
          rotate: 90
        params:
          text: LEDd
      led_mostfet_jumper_label:
        what: ceoloide/utility_text
        where:
          ref: matrix_innermod_num
          shift: [13,8.5]
          rotate: 90
        params:
          text: LEDp
      encoder_E1_jumper:
        what: aevumdecessus/jumper
        where:
          ref: matrix_innermod_num
          shift: [10.5,5.5]
          rotate: 270
        params:
          side: B
          from: P0
          to: E1
      encoder_E2_jumper:
        what: aevumdecessus/jumper
        where:
          ref: matrix_innermod_num
          shift: [13,5.5]
          rotate: 270
        params:
          side: B
          from: P4
          to: E2
      encoder_E1_jumper_label:
        what: ceoloide/utility_text
        where:
          ref: matrix_innermod_num
          shift: [10.5,8.5]
          rotate: 90
        params:
          side: B
          text: ENC1
          mirrored: true
      encoder_E2_jumper_label:
        what: ceoloide/utility_text
        where:
          ref: matrix_innermod_num
          shift: [13,8.5]
          rotate: 90
        params:
          side: B
          text: ENC2
          mirrored: true
      choose_one_label:
        what: ceoloide/utility_text
        where:
          ref: matrix_innermod_num
          shift: [4,11.5]
        params:
          text: LED OR ENC
          reversible: true
      battery_jst:
        what: ceoloide/battery_connector_jst_ph_2
        where:
          ref: mcu_top_right
          ## Shift slightly right of "center" in order to actually center it with the rotation
          shift: [(mcu_padding / 2) , -8]
          rotate: 180
        params:
          reversible: true
          include_traces: true
          use_rectangular_jumpers: true
          trace_width: pwr_trace_width
      ## Power and Reset Switches ##
      power_switch:
        what: ceoloide/power_switch_smd_side
        where:
          ref: mcu_bottom_right
          shift: [(mcu_padding / 2), kx]
        params:
          reversible: true
          include_courtyard: true
          from: BAT_P
          to: RAW
      reset_switch:
        what: ceoloide/reset_switch_tht_top
        where:
          ref: mcu_bottom_right
          shift: [mcu_padding / 2 , 0]
          rotate: 90
        params:
          reversible: true
          from: GND
          to: RS
      ## Rotary Encoder
      rotary_encoder:
        what: ceoloide/rotary_encoder_ec11_ec12
        where: [encoder]
        adjust:
          rotate: 180
        params:
          reversible: true
          include_silkscreen: true
          include_plated_mounting_holes: false
          include_plate_hole_marking: false
          mounting_holes_height: 2.8
          mounting_holes_width: 1.5
          S1: "{{column_net}}"
          S2: "{{colrow}}"
          A: E1
          C: E2
      encoder_diode:
        what: ceoloide/diode_tht_sod123
        where: [encoder]
        params:
          reversible: true
          include_tht: true
          include_traces_vias: true
          from: "{{colrow}}"
          to: "{{row_net}}"
        adjust:
          shift: [0, 0]
          rotate: 270
      encoder_diode_route:
        what: ceoloide/utility_router
        where: [encoder]
        params:
          net: "{{colrow}}"
          route: "b(-2.5,7)(0,4)"
          locked: false
      led_mosfet_gate_diode:
        what: ceoloide/diode_tht_sod123
        where:
          ref: matrix_innermod_home
          shift: [11.5, 4]
          rotate: 90
        params:
          reversible: true
          include_tht: true
          include_traces_vias: true
          trace_width: signal_trace_width
          via_size: via_size
          via_drill: via_drill
          from: LED_MFET_GATE
          to: J_MFET_GATE
      led_mosfet_gate_diode_text:
        what: ceoloide/utility_text
        where:
          ref: matrix_innermod_home
          shift: [13.5, 4]
          rotate: 90
        params:
          text: D40 gate 1N4148
          reversible: true
      ## Silkscreen Text ##
      board_name_version:
        what: ceoloide/utility_text
        where:
          ref: matrix_innermod_bottom
          shift: [-0.5kx, -0.8ky]
        params:
          reversible: true
          bold: true
          height: 2.5
          width: 2.5
          text: "{{kb_name}} V{{version}}"
      board_url:
        what: ceoloide/utility_text
        where:
          ref: thumbs_t_col0_near
          shift: [-0.45kx, -1.05ky]
        params:
          reversible: true
          bold: true
          height: 0.8
          width: 0.8
          text: "{{kb_url}}"
      author:
        what: ceoloide/utility_text
        where:
          ref: matrix_innermod_bottom
          shift: [0, -0.95ky]
        params:
          reversible: true
          bold: false
          height: 1
          width: 1
          text: "by {{kb_author}}"
      left_hand:
        what: ceoloide/utility_text
        where:
          ref: [matrix_inner_num]
          shift: [0.25kx, 0.72ky]
        params:
          side: F
          mirrored: false
          bold: true
          height: 3
          width: 3
          text: Left Hand
      right_hand:
        what: ceoloide/utility_text
        where:
          ref: [matrix_inner_num]
          shift: [0.25kx, 0.72ky]
        params:
          side: B
          mirrored: true
          bold: true
          height: 3
          width: 3
          text: Right Hand
      battery_connector_text:
        what: ceoloide/utility_text
        where:
          ref: mcu_top_left
          shift: [mcu_width / 2, mcu_padding / 2]
        params:
          reversible: true
          height: 1
          width: 1
          text: mount battery connector\ntop side if under mcu\nbottom side if larger
      switch_row_label:
        what: ceoloide/utility_text
        where: [keyswitch]
        adjust:
          shift: [8.5, 7]
        params:
          reversible: true
          text: "{{row_net}}"
      switch_column_label:
        what: ceoloide/utility_text
        where: [keyswitch]
        adjust:
          shift: [-8.5, -4.5]
        params:
          reversible: true
          text: "{{column_net}}"
      ## Screw Holes ##
      board_mounting_holes:
        what: ceoloide/mounting_hole_npth
        where: /^screws/
        params:
          hole_size: screw_hole
          hole_drill: screw_hole
          designator: 'MH'
      ## Static trace routes ##
      key_colrow_trace_net:
        what: ceoloide/utility_router
        where: [keyswitch]
        params:
          net: "{{colrow}}"
          route: "f(6.5,5)(6.5,-4)"
          locked: false
          width: signal_trace_width
      col_routes:
        what: ceoloide/utility_router
        where: /^matrix_.*_(?!num)/
        params:
          net: "{{column_net}}"
          route: "b(-6,5)(-6,2)(-7,1)(-7,-1)(-6,-2)(-6,-14)"
          locked: false
          width: signal_trace_width
      thumb_col_routes:
        what: ceoloide/utility_router
        where: /^thumbs_(?!t_col0).*_near/
        params:
          net: "{{column_net}}"
          route: "b(-6,5)(-6,2)(-7,1)(-7,-1)(-6,-2)(-6,-14)"
          locked: false
          width: signal_trace_width
cases:
  _xl_bottom:
    - name: _outer_wall
      extrude: plate_thickness
  _pcb_bottom:
    - name: _pcb_outline
      extrude: plate_thickness
  _wall_switch_plate:
    - name: _case_wall
      extrude: wall_height_switch_plate
  _wall_pcb:
    - name: _case_wall
      extrude: wall_height_pcb
  _wall_deep:
    - name: _case_wall
      extrude: wall_height_deep
  _case_underglow_holes:
    - name: _underglow_holes
      extrude: plate_thickness
  _case_standoffs_heatset:
    - name: _standoffs
      extrude: heatset_height
  _case_standoffs_deep:
    - name: _standoffs
      extrude: standoff_height_deep
  _case_standoff_holes:
    - name: _standoff_holes
      extrude: heatset_height
  _pcb_plate_holes:
    - name: _screw_holes
      extrude: plate_thickness
  _case_bottom: # The bottom surface of the case with standoffs
    - what: case
      name: _xl_bottom
      operation: add
    - what: case
      name: _case_underglow_holes
      operation: subtract
    - what: case
      name: _case_standoffs_heatset
      operation: add
    - what: case
      name: _case_standoff_holes
      operation: subtract
  _case_bottom_deep:
    - what: case
      name: _xl_bottom
      operation: add
    - what: case
      name: _case_underglow_holes
      operation: subtract
    - what: case
      name: _case_standoffs_deep
      operation: add
    - what: case
      name: _case_standoff_holes  
      shift: [0,0,standoff_height_deep-heatset_height]
      operation: subtract
  bottom_plate: # Bottom plate with screw holes instead of a full case
    - what: case
      name: _pcb_bottom
      operation: add
    - what: case
      name: _pcb_plate_holes
      operation: subtract
    - what: case
      name: _case_underglow_holes
      operation: subtract
  bottom_case_deep:
    - what: case
      name: _case_bottom_deep
      operation: add
    - what: case
      name: _wall_deep
      operation: add
  bottom_case_switch: # Case with walls to the surface of the switch plate
    - what: case
      name: _case_bottom
      operation: add
    - what: case
      name: _wall_switch_plate
      operation: add
  bottom_case_pcb: # Case with walls to the surface of the PCB
    - what: case
      name: _case_bottom
      operation: add
    - what: case
      name: _wall_pcb
      operation: add
  switch_test_plate:
    - name: _switch_test_plate
      extrude: 2
