AevumDecessus/Ergo-Nano/(commit log)

2026-10-27 Initial config - only contains keys and board
2026-10-27 Added space for the MCU to the right
    Also shifted the whole board down to fit into kicad
2026-10-27 Added footprints for switches and diodes
2026-10-27 Added mounting holes
2026-10-27 Parameterized more variables, initial lower board
    Outline only to start
2026-10-27 Added initial case design
2026-10-27 Add a tolerance gap around the board for case fit
    [config.yaml]
2026-10-27 Specify all mount locations for reuse
2026-10-27 Don't render keys on mount locations
2026-10-27 Add standoffs with heatset insert holes
2026-10-28 Added missing column of keys
    [config.yaml]
2026-10-28 tweaked mount hole position with new column
2026-10-28 shortened net names
    needed to fit labels under the MCU
    [config.yaml]
2026-10-28 Added switches/connectors
    * power switch (DPDT)
    * reset switch (momentary)
    * battery JST
    small movement tweaks
2026-10-28 increased global padding to give a little more space around the diodes
2026-10-28 Added ceoloide footprint library
2026-10-28 current ergogen output
    [board.dxf, board.kicad_pcb, combo.dxf, keys.dxf]
2026-10-28 Ignore kicad lock files
2026-10-28 changed the thumb cluster column names to be clear and prevent overlaps
    [board.dxf, board.kicad_pcb, combo.dxf]
2026-10-28 auto-route the switch-diode routes
    [board.kicad_pcb]
2026-10-28 Route column nets
    renamed inner_mod column to innermod to make regex matching simpler
    [board.kicad_pcb]
2026-10-28 Specify diode position with units
    Lock generated traces
    [board.kicad_pcb]
2026-10-28 Added board text to silkscreen
    [board.kicad_pcb]
2026-10-28 Removed the 90 degree traces for columns and diodes
    [board.kicad_pcb]
2026-10-28 Output to subdirectories of the project top level
    [board.dxf, board.kicad_pcb, combo.dxf, keys.dxf]
2026-10-28 Auto generate an STL for the case for 3d printing
    [bottom_case.stl]
2026-10-28 Organized points with tags, added switch_plate
    [board.dxf, board.kicad_pcb, bottom_case.stl, combo.dxf, keys.dxf, switch_plate.dxf]
2026-10-28 Tweaked mount points to avoid any switch overlap
    Mounts near the offset columns were close to overlapping adjacent
    switches
    [board.kicad_pcb, bottom_case.stl, switch_plate.dxf]
2026-10-28 Parameterized more of the layout and subdivided
    MCU has a proper outline now that combines with the key outline for the
    PCB/case
    Switch plate only uses the key outlines for sizing now
    [board.dxf, board.kicad_pcb, bottom_case.stl, combo.dxf, keys.dxf, switch_plate.dxf]
2026-10-28 Extrude teh walls to the top of the top plate
    [bottom_case.stl]
2026-10-29 Added more meta tags, minor shifts of case/pcb design
    [board.kicad_pcb, bottom_case.stl, combo.dxf]
2026-10-29 Added many documentation comments, some additions
    Now has 3 cases, one for just a bottom plate, one with walls up to the
    PCB height, one with walls up to the top of the switch plate.
    Actually put the screw head size around each mounting hold, moved the
    diodes and traces slightly to adjust
    [board.kicad_pcb, bottom_case.stl, bottom_case_pcb.stl, bottom_case_switch.stl, bottom_plate.stl]
2026-10-29 Moved the screw to the bottom right of the MCU
    Was overlapping the display slightly
    [board.kicad_pcb, bottom_case_pcb.stl, bottom_case_switch.stl, bottom_plate.stl]
2026-10-29 More comments, shift battery jst to the right
    [board.kicad_pcb]
2026-10-29 set mcu padding separately for space for switches
    Small tweaks
2026-10-29 Added optional rotary encoder
2026-10-29 Built previous commit
    [board.kicad_pcb, bottom_case_pcb.stl, bottom_case_switch.stl, bottom_plate.stl, combo.dxf]
2026-10-29 Generate all pcb plates as alternative to case stl
    Can also be used to generate acrylic cut patterns
    Output SVG previews of outlines
    [backplate.kicad_pcb, combo.dxf, ergonano.kicad_pcb, preview.dxf, switchplate.dxf, switchplate.kicad_pcb]
2026-10-29 Tweaked layout, moved battery connector
    shrinks the overall PCB by shrinking the mcu_padding
    [backplate.kicad_pcb, bottom_case_pcb.stl, bottom_case_switch.stl, bottom_plate.stl, ergonano.kicad_pcb, preview.dxf]
2026-10-30 Use a drill for all screw holes on generated pcb plates
    don't plate the encoder mounting holes (kicad jlcpcb violation)
    [backplate.dxf, backplate.kicad_pcb, ergonano.kicad_pcb, switchplate.dxf, switchplate.kicad_pcb]
2026-10-30 moved the battery connector text
    also resized to meet JLCPCB minimums
    [ergonano.kicad_pcb]
2026-10-31 Small renames, tweaks to freerouting rules
    [backplate.kicad_pcb, ergonano.kicad_pcb, preview.dxf, switchplate.kicad_pcb]
2026-10-31 Removed accidental 2nd encoder, added more data to key switches
    [ergonano.kicad_pcb, preview.dxf]
2026-10-31 make net names shorter, build tweaks
    be more granular with JLCPCB requirements
    [ergonano.kicad_pcb, preview.dxf]
2026-10-31 Added silkscreen labels for switch rows, nets, and names
    [ergonano.kicad_pcb]
2026-10-31 Don't leave a pad at a 45 degree angle
    [ergonano.kicad_pcb]
2026-10-31 fully define display location with points and show on preview. Rotate encoder footprint
    [backplate.dxf, backplate.kicad_pcb, bottom_case_pcb.stl, bottom_case_switch.stl, bottom_plate.stl, ergonano.kicad_pcb, preview.dxf]
2026-10-31 wall thickness is variable, use only screws where they can be evenly offset from keyswitches
    [backplate.dxf, backplate.kicad_pcb, bottom_case_pcb.stl, bottom_case_switch.stl, bottom_plate.stl, ergonano.kicad_pcb, preview.dxf, switchplate.dxf]
2026-10-31 v0.1 release
    [backplate.kicad_pcb, ergonano.kicad_pcb, ergonano_autorouted.kicad_pcb, switchplate.kicad_pcb]
2026-11-01 Added deep case to accomodate larger batteries
    also dropped the 2U key for a 1.5U key to not need stabilizers
    [backplate.kicad_pcb, bottom_case_deep.stl, ergonano.kicad_pcb, preview.dxf, switchplate.kicad_pcb]
2026-11-01 Added forked ergogen footprints temporarily
2026-11-01 Added per-key LED, requires a bunch of rework
    [backplate.dxf, backplate.kicad_pcb, bottom_case_deep.stl, bottom_case_pcb.stl, bottom_case_switch.stl, bottom_plate.stl, ergonano.kicad_pcb, preview.dxf]
2026-11-02 unify tags as arrays, rotate LEDs 180 every other row
    [backplate.kicad_pcb, ergonano.kicad_pcb, preview.dxf, switchplate.kicad_pcb]
2026-11-02 added missing LED_DIR to thumb_cluster
    [ergonano.kicad_pcb]
2026-11-02 route the GND for every LED to it's centerhole net
    [ergonano.kicad_pcb]
2026-11-02 Use forked battery_connector footprint
    Lets us use rectangular jumpers
2026-11-02 Fixed more nets on static routes
    [ergonano.kicad_pcb]
2026-11-02 Fix some labels, increase space around silkscreens
    [config.yaml]
2026-11-02 shrink text slightly to fix silkscreen violations
    [ergonano.kicad_pcb, preview.dxf]
2026-11-02 Added LED resistor
    updated footprints submodule
    [bottom_plate.stl, ergonano.kicad_pcb]
2026-11-04 Added jumper footprint and LED or ENC jumper pair
    [backplate.kicad_pcb, bottom_plate.stl, ergonano.kicad_pcb, switchplate.kicad_pcb]
2026-11-04 Added underglow LEDs and cutouts for them to shine through
    [backplate.dxf, backplate.kicad_pcb, bottom_case_deep.stl, bottom_case_pcb.stl, bottom_case_switch.stl, bottom_plate.stl, ergonano.kicad_pcb]
2026-11-04 0.2 release
    [backplate.kicad_pcb, ergonano.kicad_pcb, ergonano_autorouted.kicad_pcb, switchplate.kicad_pcb]
2026-11-05 fix: fatal flaws identified and partially fixed
    * Power switch now routes to `RAW` instead of `VCC`
    * LEDs are now on a separate LED_VCC rail
    * TODO: Implement mosfet footprint and wire between `RAW` and
    `LED_VCC`
    * Both Encoder Pins are now solder-selectable
    * P0 -> E1
    * P4 -> E2
    * LED data and LED mosfet control are now solder-selectable
    * P0 -> LED Data
    * P4 -> LED Mosfet gate (to be implemented)
    [backplate.kicad_pcb, bottom_plate.stl, ergonano.kicad_pcb, switchplate.kicad_pcb]
2026-11-05 Minor update to README with findings from 0.2 board
2026-11-05 Updated submodule to include SOT-23 footprint
2026-11-05 Added missing mosfet and pullup resistor
    [ergonano.kicad_pcb]
2026-11-05 Remove plated holes from keyswitches
    simplifies static routing and some issues with clearances
    [config.yaml]
2026-11-05 regenerated baseline pcb after prior commit
    [ergonano.kicad_pcb]
2026-11-05 Increase default autorouting timeout
    board is complex and requires some time
2026-11-05 Fixed led numbering and encoder diode route
    [config.yaml]
2026-11-05 Fix where for diodes, incorrect col_net
    [config.yaml]
2026-11-05 Fixed MOSI net on display
    [config.yaml]
2026-11-06 unified some pcb trace options
    updated footprint library
    [backplate.kicad_pcb, bottom_plate.stl, ergonano.kicad_pcb, switchplate.kicad_pcb]
2026-11-06 tweaked some rules, make vias bigger to fix anneal ring drc errors
    [ergonano.kicad_pcb]
2026-11-06 footprint updates
2026-11-07 Added an underglow LED to the thumbs cluster
    silkscreen for underglow is now `Underglow`
    [backplate.dxf, backplate.kicad_pcb, bottom_case_deep.stl, bottom_case_pcb.stl, bottom_case_switch.stl, bottom_plate.stl, ergonano.kicad_pcb, switchplate.kicad_pcb]
2026-11-07 Footprint update to tweak resistor silkscreen
    [ergonano.kicad_pcb]
2026-11-07 0.3 release
    * Fixed battery connection to connect to `RAW` instead of `VCC`
    * Moved all LED's to a `LED_VCC` net for power
    * Added a mosfet to control power draw of LEDs
    * Many smaller tweaks and configs
    [backplate.kicad_pcb, ergonano.kicad_pcb, ergonano_autorouted.kicad_pcb, switchplate.kicad_pcb]
2026-11-07 Parameterized kb_url
    Added JLC order text field
    Moved all the big silkscreens to the deadspace above thumb cluster
    [backplate.kicad_pcb, ergonano.kicad_pcb, switchplate.kicad_pcb]
2026-11-07 v0.3.1 - silkscreen and config only changes
    [backplate.kicad_pcb, ergonano.kicad_pcb, ergonano_autorouted.kicad_pcb, switchplate.kicad_pcb]
2026-11-07 Use my version of the nice_view footprint
    fixes silkscreen to pad clearance issue with current version of upstream from ceoloide
    [config.yaml]
2026-11-09 Added switch test plate STL
    [switch_test_plate.stl]
2026-11-09 Moved the thumb cluster to the right and angled
    Tweaks after printing out a test switchplate stl and placing switches
    and keys in their positions.
    [backplate.dxf, backplate.kicad_pcb, bottom_case_deep.stl, bottom_case_pcb.stl, bottom_case_switch.stl, bottom_plate.stl, ergonano.kicad_pcb, preview.dxf]
2026-11-10 0.4.0 release
    [backplate.kicad_pcb, ergonano.kicad_pcb, ergonano_autorouted.kicad_pcb, switchplate.kicad_pcb]
2026-11-13 Added series `1N4148` gate protection diode (`D40`, `led_mosfet_gate_diode`) between `J2` (`J_MFET_GATE`) and `LED_MFET_GATE` to isolate `P4` (3.3 V) from `RAW` (up to 4.2 V) when LEDs are off, preve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
    [config.yaml]
2026-11-13 shrink and shift the underglow labels to fix silkscreen clearance, added arrows
    [config.yaml]
2026-11-13 Updated `kibot/import_ses.py` to remove sub-micron (`<= 0.001 mm`) dangling track stubs left by Specctra SES import.
2026-11-13 We know the NPTH holes in the switch footprint overlap, that's perfectly fine, they are within manufacturer tolerances
2026-11-13 Ignore "missing" footprint issues from ergogen
2026-11-13 Automatically clean up dangling traces and autosplit T junctions as part of build
2026-11-13 Added label to LED MOSFET, starting 0.5.0 prep changes
2026-11-13 Clean up non-board related changelog entries
2026-11-13 reverted changelog and config version to 0.4.0 in prep to test new release workflows
    [config.yaml]
2026-11-13 chore: release v0.5.1
    [backplate.kicad_pcb, ergonano.kicad_pcb, ergonano_autorouted.kicad_pcb, switchplate.kicad_pcb]
2026-11-13 major update - flipped switch and LED orientation 180
    LEDs are now north-facing for key illumination
    [config.yaml]
